zero-volts/zerovolts-ui/case/stl/bottom.stl

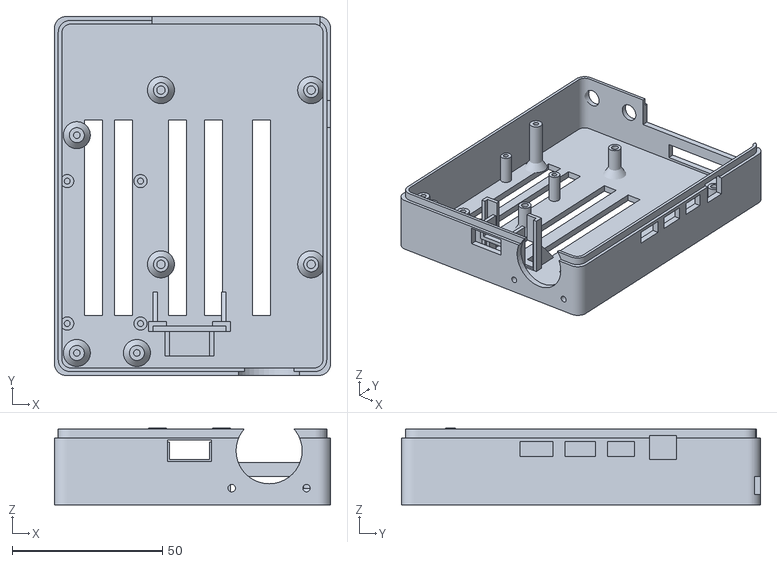
[picture p1: CAD file, 2026-11-09]
case/stl/bottom.stl
92.0 x 119.5 x 25.5
