zero-volts/zerovolts-ui/case/stl/ir_tx.stl

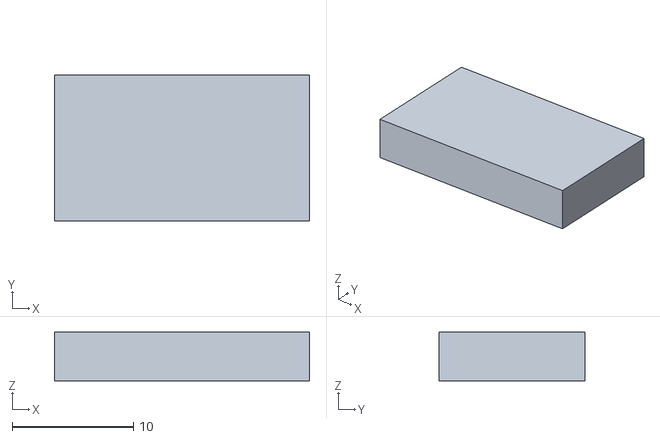
[picture p2: CAD file, 2026-11-09]
case/stl/ir_tx.stl
21.0 x 12.0 x 4.00
