zero-volts/zerovolts-ui/case/stl/rpi.stl

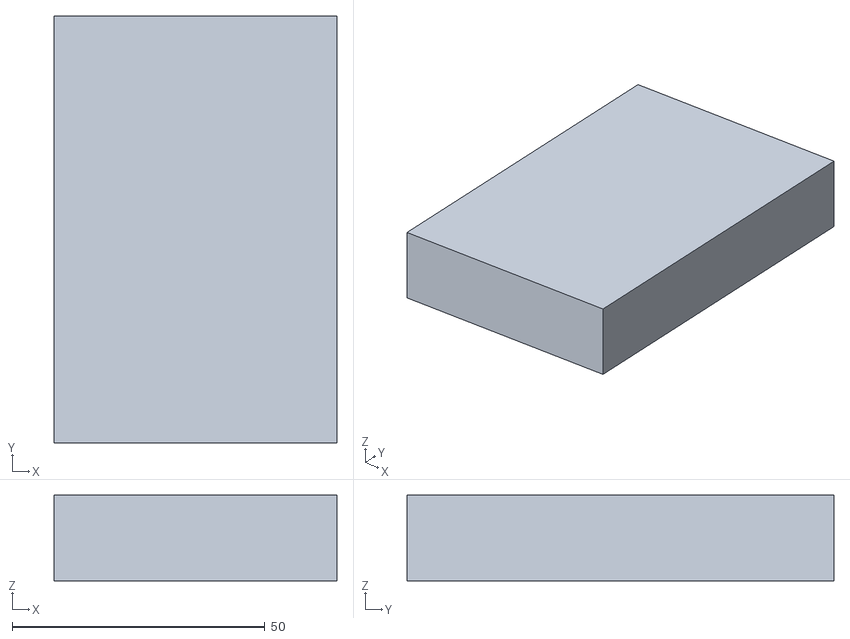
[picture p3: CAD file, 2026-11-09]
case/stl/rpi.stl
56.0 x 84.5 x 17.0
