zero-volts/zerovolts-ui/case/stl/ventilador.stl

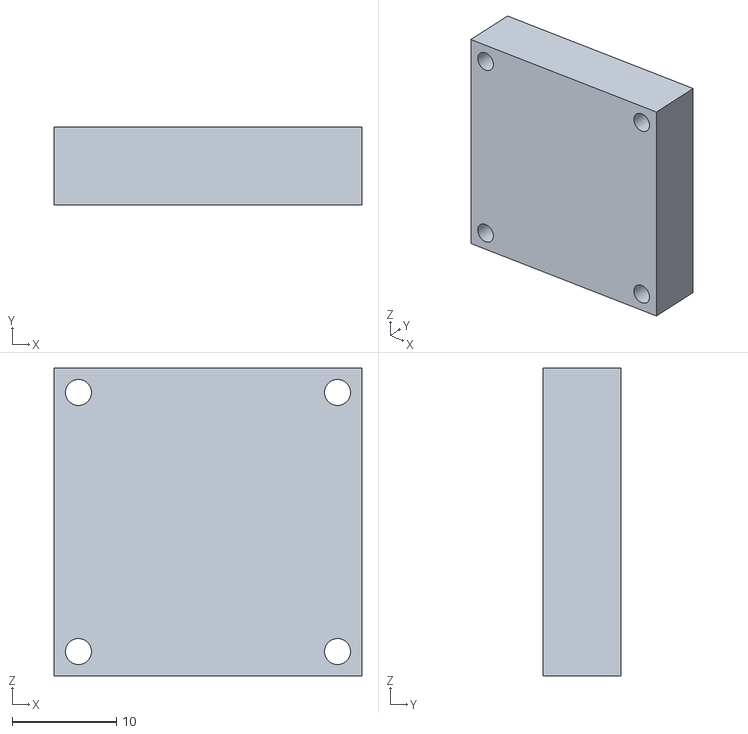
[picture p4: CAD file, 2026-11-09]
case/stl/ventilador.stl
29.6 x 7.50 x 29.6
