zero-volts/zerovolts-ui/case/stl/antennas.stl

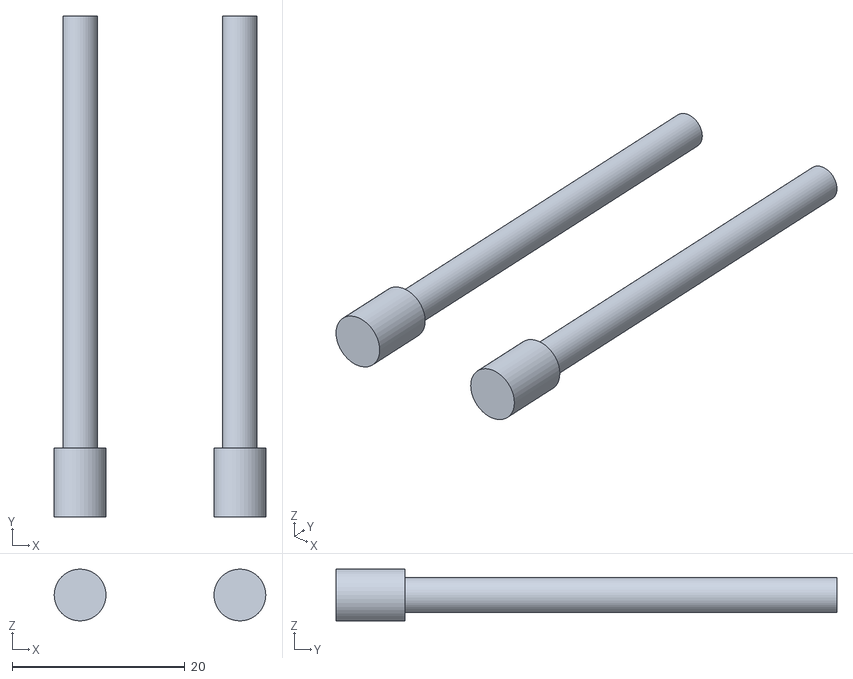
[picture p5: CAD file, 2026-11-09]
case/stl/antennas.stl
24.5 x 58.0 x 6.00
