zero-volts/zerovolts-ui/case/stl/nrf24.stl

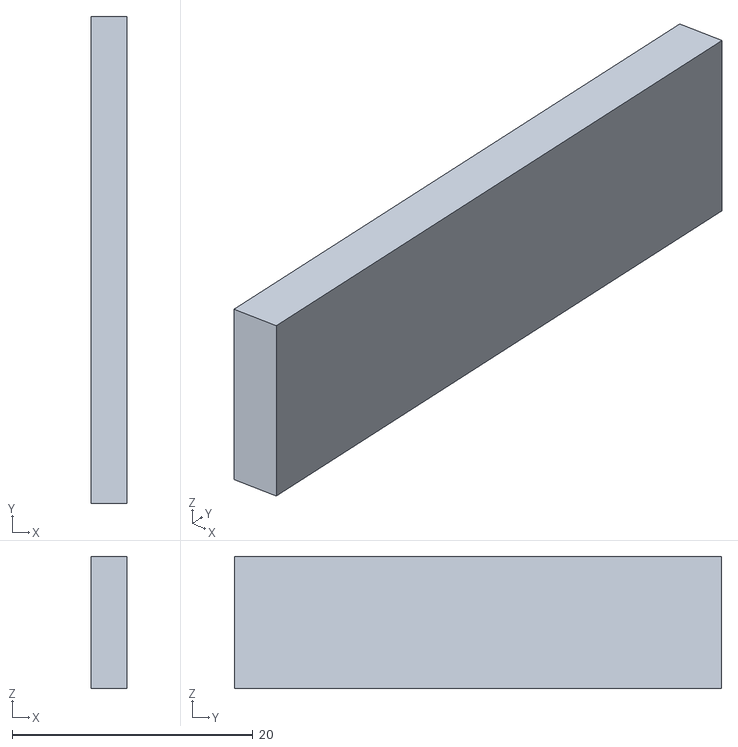
[picture p6: CAD file, 2026-11-09]
case/stl/nrf24.stl
3.00 x 40.5 x 11.0
