zero-volts/zerovolts-ui/case/stl/rc522.stl

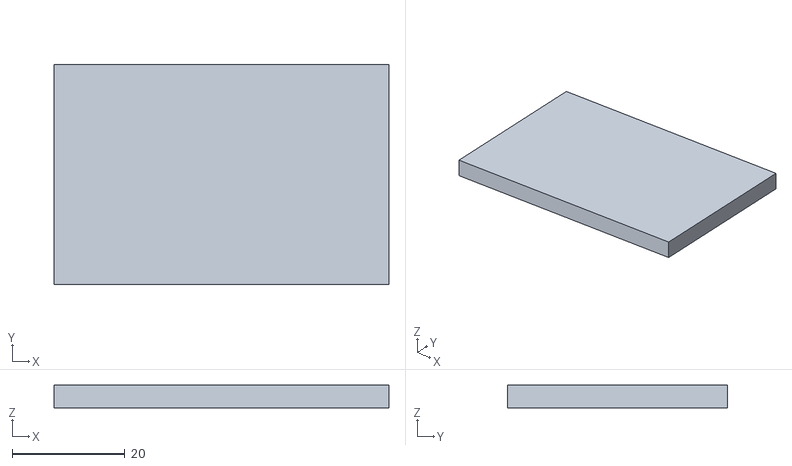
[picture p7: CAD file, 2026-11-09]
case/stl/rc522.stl
59.5 x 39.0 x 4.00
