zero-volts/zerovolts-ui/case/stl/usb_dock.stl

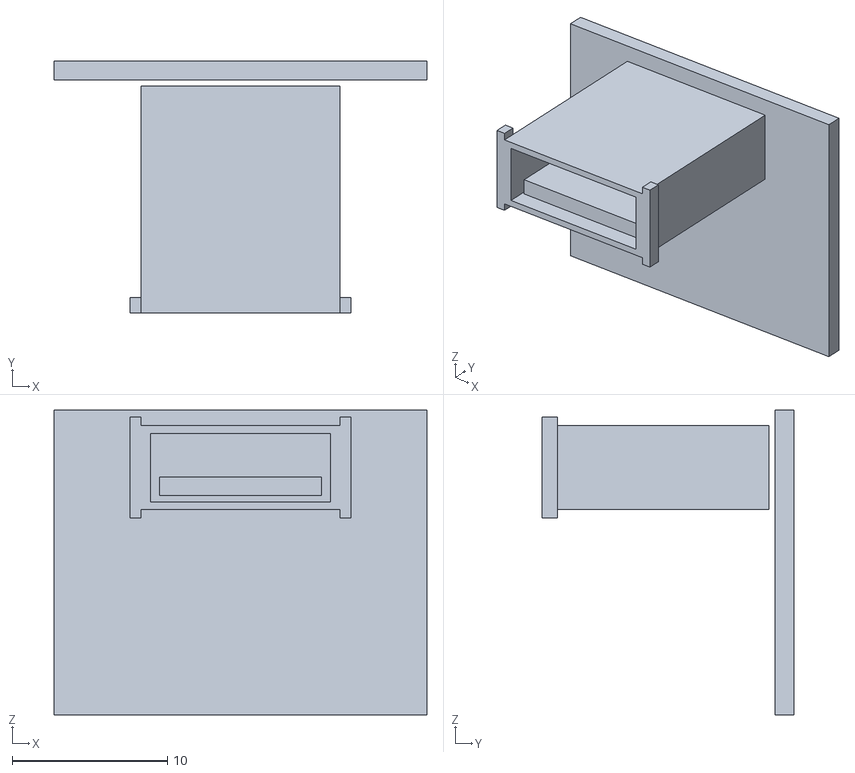
[picture p8: CAD file, 2026-11-09]
case/stl/usb_dock.stl
24.0 x 16.2 x 19.6
