zero-volts/zerovolts-ui/case/stl/esp32.stl

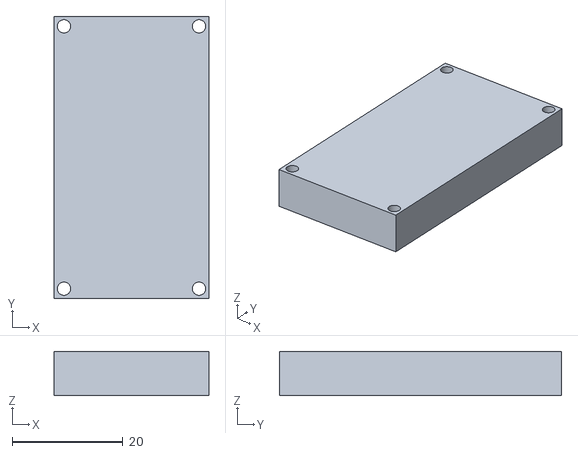
[picture p9: CAD file, 2026-11-09]
case/stl/esp32.stl
28.0 x 51.0 x 8.00
