zero-volts/zerovolts-ui/case/stl/cc1101.stl

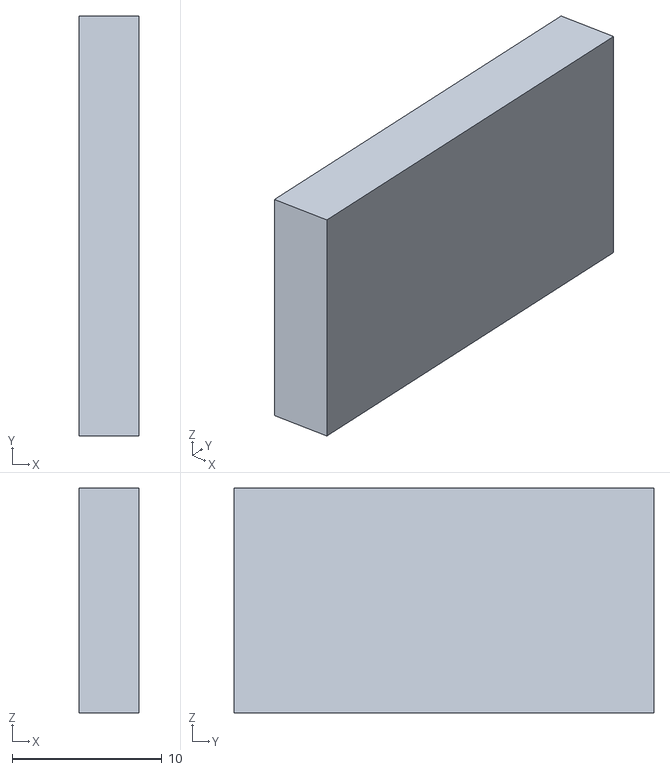
[picture p10: CAD file, 2026-11-09]
case/stl/cc1101.stl
4.00 x 28.0 x 15.0
