zero-volts/zerovolts-ui/case/stl/screen.stl

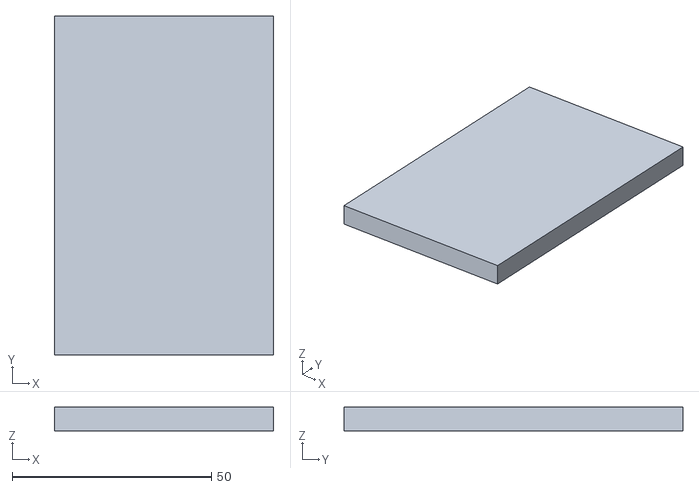
[picture p11: CAD file, 2026-11-09]
case/stl/screen.stl
55.0 x 85.0 x 6.00
