zero-volts/zerovolts-ui/case/stl/top.stl

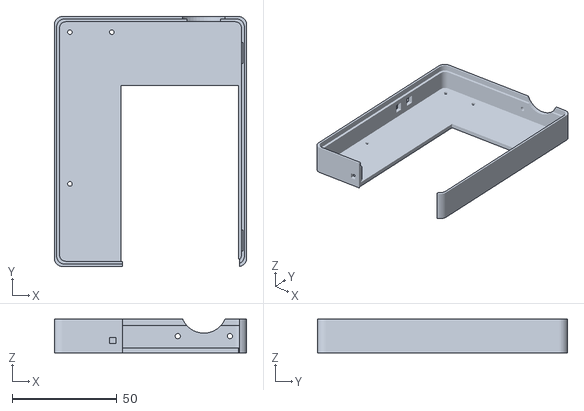
[picture p12: CAD file, 2026-11-09]
case/stl/top.stl
92.0 x 119.5 x 16.2
