zero-volts/zerovolts-ui/(list of files, cad)

Other CAD files:
case/stl/ir_rx.stl
