zero-volts/zerovolts-ui/types.h

#ifndef TYPES_H
#define TYPES_H
#ifdef __cplusplus
extern "C" {
#endif

#include <stdint.h>
#include <stdio.h>

#define UNKNOWN_NAME "Unknown"
#define BT_ALLOWED_MAX_DEVICES 20
#define BT_MAX_SERVICES 20
#define BT_MAX_CHARS_PER_SERVICE 16
#define BT_UUID_STR_LEN 37

#define SUBGHZ_ALLOWED_MAX_SESSIONS 5
#define SUBGHZ_DATA_CHUNK_MAX_VALUES 32
#define SUBGHZ_CAPTURE_MAX_TIMINGS 256

typedef struct {
    char name[32];
    char mac[18];
    int rssi;
    char manufacturer[32];
    char appearance[32];
    char service[32];
    int connectable;
    int addr_type;
} device_t;

typedef struct {
    int char_index;
    char uuid[BT_UUID_STR_LEN];
    unsigned int props;
    unsigned int handle;
} bt_characteristic_t;

typedef struct {
    int svc_index;
    char uuid[BT_UUID_STR_LEN];
    bt_characteristic_t chars[BT_MAX_CHARS_PER_SERVICE];
    int chars_count;
} bt_service_t;

typedef enum {
    UI_IDLE = 0,
    UI_LOADING,
    UI_DONE,
    UI_ERROR,
    UI_TIMEOUT
} ui_status_t;

typedef enum {
    BT_IDLE = 0,
    BT_CONNECTING,
    BT_CONNECTED,
    BT_DISCOVERING,
    BT_READY,
    BT_FAILED,
    BT_LOST,
    BT_DISCONNECTED,
    BT_SCANNING,
    BT_TIMEOUT
} bt_status_t;

typedef struct {
    uint64_t capture_id;
    uint16_t seq;
    uint16_t chunks;
    uint16_t count;
    int32_t timings[32];
} subghz_data_chunk_t;

typedef struct {
    char name[256];
    char path[1024];
} zv_file_path_item;

typedef struct {
    zv_file_path_item *signals;
    size_t count;
} zv_file_item_list;

#ifdef __cplusplus
}
#endif

#endif /* TYPES_H */
