zero-volts/zerovolts-ui/examples/main_touch_calibration.c

#include "lvgl.h"
#include "lv_linux_fbdev.h"
#include <unistd.h>
#include <stdio.h>


static void btn_event_cb(lv_event_t * e)
{
     printf("button pressed \n");
}

int driver_initialization(lv_display_t *display)
{
    lv_linux_fbdev_set_file(display, "/dev/fb0");
    // To know the event we use "cat /proc/bus/input/devices"
    lv_indev_t *touch = lv_evdev_create(LV_INDEV_TYPE_POINTER, "/dev/input/event4");
    if (!touch)
        return -1;

    // We swap axes because LVGL don't know that the screen is rotated 90degrees, so with
    // this swap the input are fixed internally.
    lv_evdev_set_swap_axes(touch, true);

    // We use evtest /dev/input/event4 command to know the screen edges points.
    lv_evdev_set_calibration(touch, 296, 294, 3931, 3843);

    return 0;
}

int main(void)
{ 
    lv_init();

    lv_display_t *display = lv_linux_fbdev_create();
    if (!display)
    {
        printf("Can't create the display!\n");
        return -1;
    }

    int sucess = driver_initialization(display);
    if (sucess == -1)
    {
        printf("Can't initialize the driver!\n");
        return -1;
    }

    lv_obj_t *active_screen = lv_screen_active();

    lv_obj_t *btn = lv_button_create(active_screen);
    lv_obj_align(btn, LV_ALIGN_CENTER, 0, 0);
    lv_obj_set_size(btn, 120, 50);
    lv_obj_add_event_cb(btn, btn_event_cb, LV_EVENT_CLICKED, NULL);

    lv_obj_t *label = lv_label_create(btn);
    lv_label_set_text(label, "Button");
    lv_obj_center(label);
    
     while(1) {
         lv_timer_handler();
         usleep(5000);
    }

    return 0;
}
