zero-volts/zerovolts-ui/examples/main_hello_world.c

#include "lvgl.h"
#include "lv_linux_fbdev.h"
#include <unistd.h>
#include <stdio.h>

int main(void)
{ 
    lv_init();

    lv_display_t *display = lv_linux_fbdev_create();
    if (!display) {
        printf("No puedo crear el display!\n");
        return -1;
    } 

    lv_linux_fbdev_set_file(display, "/dev/fb0");
        
    lv_obj_t *active_screen = lv_screen_active();

    lv_obj_t *label = lv_label_create(active_screen);
    lv_label_set_text(label, "Hellow World");
    lv_obj_align(label, LV_ALIGN_CENTER, 0, 0);
    
     while(1) {
         lv_timer_handler();
         usleep(5000);
    }

    return 0;
}
