zero-volts/zerovolts-ui/page/bt/bt_scanner.h

#ifndef BT_SCANNER_H
#define BT_SCANNER_H

#include "page/zv_view.h"
#include "config.h"

#ifdef __cplusplus
extern "C" {
#endif

zv_view_t *bt_scanner_page_create(const zv_config *cfg);

#ifdef __cplusplus
}
#endif

#endif /* BT_SCANNER_H */
