zero-volts/zerovolts-ui/(commit log)

2025-12-17 actualizando ejemplo de hello world
2025-12-17 actualizando ejemplo de calibracion
2025-12-17 mejoras visuales para la pantalla de hid
2025-12-18 agregando archivo de configuracion y helpers para manejo de archivos
2025-12-18 Implementado flujo para correr el script de badusb cuando se habilita
2026-01-06 agregando temperatura
2026-01-06 agregando pantalla basica para controlar infrarojos
2026-01-12 Base depaginas para el manejo de los controles infrarojos, no hay ningun handler en los eventos
2026-01-21 Mejorando para poder nevagar entre pantallas
2026-01-30 Implementando navegacion de UI a trave de botones fisicos
2026-02-04 integracion de botones fisicos con pantallas de infrarrojo y envio de señal a traves de la aplicacion funcionando
2026-02-04 corrigiendo lectura de archivos con nueva directotios para data
    [main.c]
2026-02-04 trackeando el directorio data/
2026-02-05 moviendo los ejemplos a un directorio especifico y actualizando makefile para compilarlos
2026-02-06 agregando codigo base para las vistas
2026-02-06 ordenando el codigo y moviendo creacion de elementos en sus respectivos arhivos
2026-02-08 actualizando hid para usar base_view
2026-02-11 corrigiendo implementacion de ir_service para solo manejar el envio y lectura de la señal de IR
    [ir_service.c, ir_service.h]
2026-02-11 implementando init y creacion de control remoto
2026-02-12 implementada funcion ir_controller_list_remotes para listar los controles ya creados
2026-02-12 implementando las funcionalidades de list_buttons y learn_button
2026-02-12 actualizada la ui de ir para usar el controller en vez de ir al servicio
2026-02-13 Actualizando el codigo de hid para que funcione por capas y no este todo mezclado con la UI
2026-02-13 Mejorando el README, agregando arquitectura actual del proyecto
2026-03-10 Agregando funcionalidad par escribir archivo de logs
2026-03-11 Eliminando path hardcodeados, mejoras en el uso de memoria y grabanmdo correctamente señales cortas de IR
    [config.c, config.h, ir_service.c, main.c]
2026-03-17 mejorando manejo de errores, usando log y errores en archivos comun
    [hid_service.c, ir_service.c, main.c]
2026-04-17 agregando servicio para manejar UART y pantalla para visualizar el scaneode bluetooth
2026-04-17 mejorando visualizacion de pantalla de infrarojo y corigiendo colores en lista
2026-04-17 mejorando nombres y scope de variable
2026-04-17 nuevo componente para botno de carga
2026-04-17 mejorando visualmente la pantalla de scan
2026-04-20 agregando nuevo componente para organizar la data y comenzando a mostrar el detalle de u ndispositivo seleccionado
2026-04-24 agrando nuevo componente y actualizando y organizando el panel info y la lista
2026-04-24 agrefando un pseudo contexto para mantener datos entre pantallas
2026-04-24 mejorando panallas de detalle y listado de dispositivos
2026-04-27 Mejorando el manejo edl contexto de la aplicacion
2026-04-27 mejorando como se resuleve el estado de los dispositivos
2026-04-29 leyendo datos de uart desde el config
2026-04-29 Mejorando visualmente el detalle de un dispositivo BLE y mostrando sus servicios y caracteristicas
2026-05-04 agregando iconos para usar con LVLG
2026-05-04 mejorando la forma para cargar las imagenes como iconos
2026-05-05 mejorando UI de envio de señal en IR
2026-05-05 usando Base_biew para refactorizar codigo en send_gnal y creando helpers para componentes
2026-05-06 Limpiando vistas viejas para usar componentes reutilizable y mejoras varias
2026-05-06 actualizando READMe con lo utlimo de bluetooth
2026-08-13 COdigo inicial para enviar y recibir comandos y datos de subghz desde el esp32
2026-08-14 agregando funcionalidades para scroll horizontal
2026-08-14 Mejorando la pantalla que captura la señal, se agrea un grafico inicial (NO correcto) para ver los datos
    [bt_controller.c, config.c, types.h]
2026-08-20 Corrigiendo el chart para mostrar las señales y mejorando validaciones en el parser de los datos
    [config.c, config.h, types.h]
2026-08-21 agregando contexto para guardar los chunks (mas de uno)
2026-09-10 Mejorando el codigo para mantener sparadas las capas de vista/conmtrolador y servicios para el subghz y comenzando a escribir las señales a un archivo
2026-09-14 corrigiendo el bug de overflow al guardar
    [subghz_file.c, subghz_service.c]
2026-09-29 guardando el preset faltante y agregando validaciones minimas segun el formato de flipper
    [subghz_file.c, subghz_file.h, subghz_service.c]
2026-10-02 Usando dropdown en la pantalla de captura de radiofrecuencia
2026-10-06 Agrgeando nuevos componetnes, panel, input text y agregamdolos en pantalla de IR y el de hid
2026-10-06 Se crea nuevo componente para crear botones y se mejoran el dropdown y el input text
2026-10-06 se actualiza lean_button de IR para utilizar los nuevos componentes de UI
2026-10-06 ACtualizando send_signal para usar los componentes genericos
2026-10-06 agregando mejoras en el manejo de memorias para su liberacion posterior
2026-10-06 Usando boton nuevo en el capture de subghz
2026-10-06 Implementando el loading button en ui_button
2026-10-13 Correcciones visuales, usando nuevos colores y componentes creados, usando nueva navegacion para optimizar el manejo de memoria
2026-10-20 Agregando nueva panalla para colocar nombre al archivo subghz
2026-10-21 agregando pantalla para listar las señales guardadas, pantalla no hace nada todavia
2026-10-24 pantallas de captura faltante y eplay implementadas. Enviarndo comando para hacer el replay
2026-11-09 agregando case en 3D para el proyecto
2026-11-10 Agregando opcion para dar un tamaño al item de la lista
2026-11-10 mejoras para mostrar los estados de la UI en scanner
2026-11-11 Mejoras en el IR ya no se bloquea la UI al llamar el sistema
2026-11-12 agregando validacion para el timeout cuando no responde el modulo cc1101
2026-11-13 agregando la funcionalidad de los tactile switch dentro del repo
